jra78/sarastevalo/README.md

# sarastevalo
"Sarastevalo eagle" hekemistosta löytyy piirilevyä varten eagle tiedostot (useampia versioita)
"Sarastevalo arduino" hakemistosta löytyy koodi

in "Sarastevalo eagle"-folder is eagle files (multiple versions)
in "Sarastevalo arduino" folder is code
