jra78/sarastevalo/sarastevalo eagle/controller.brd

## EAGLE design sarastevalo eagle/controller.brd (2015-01-12)

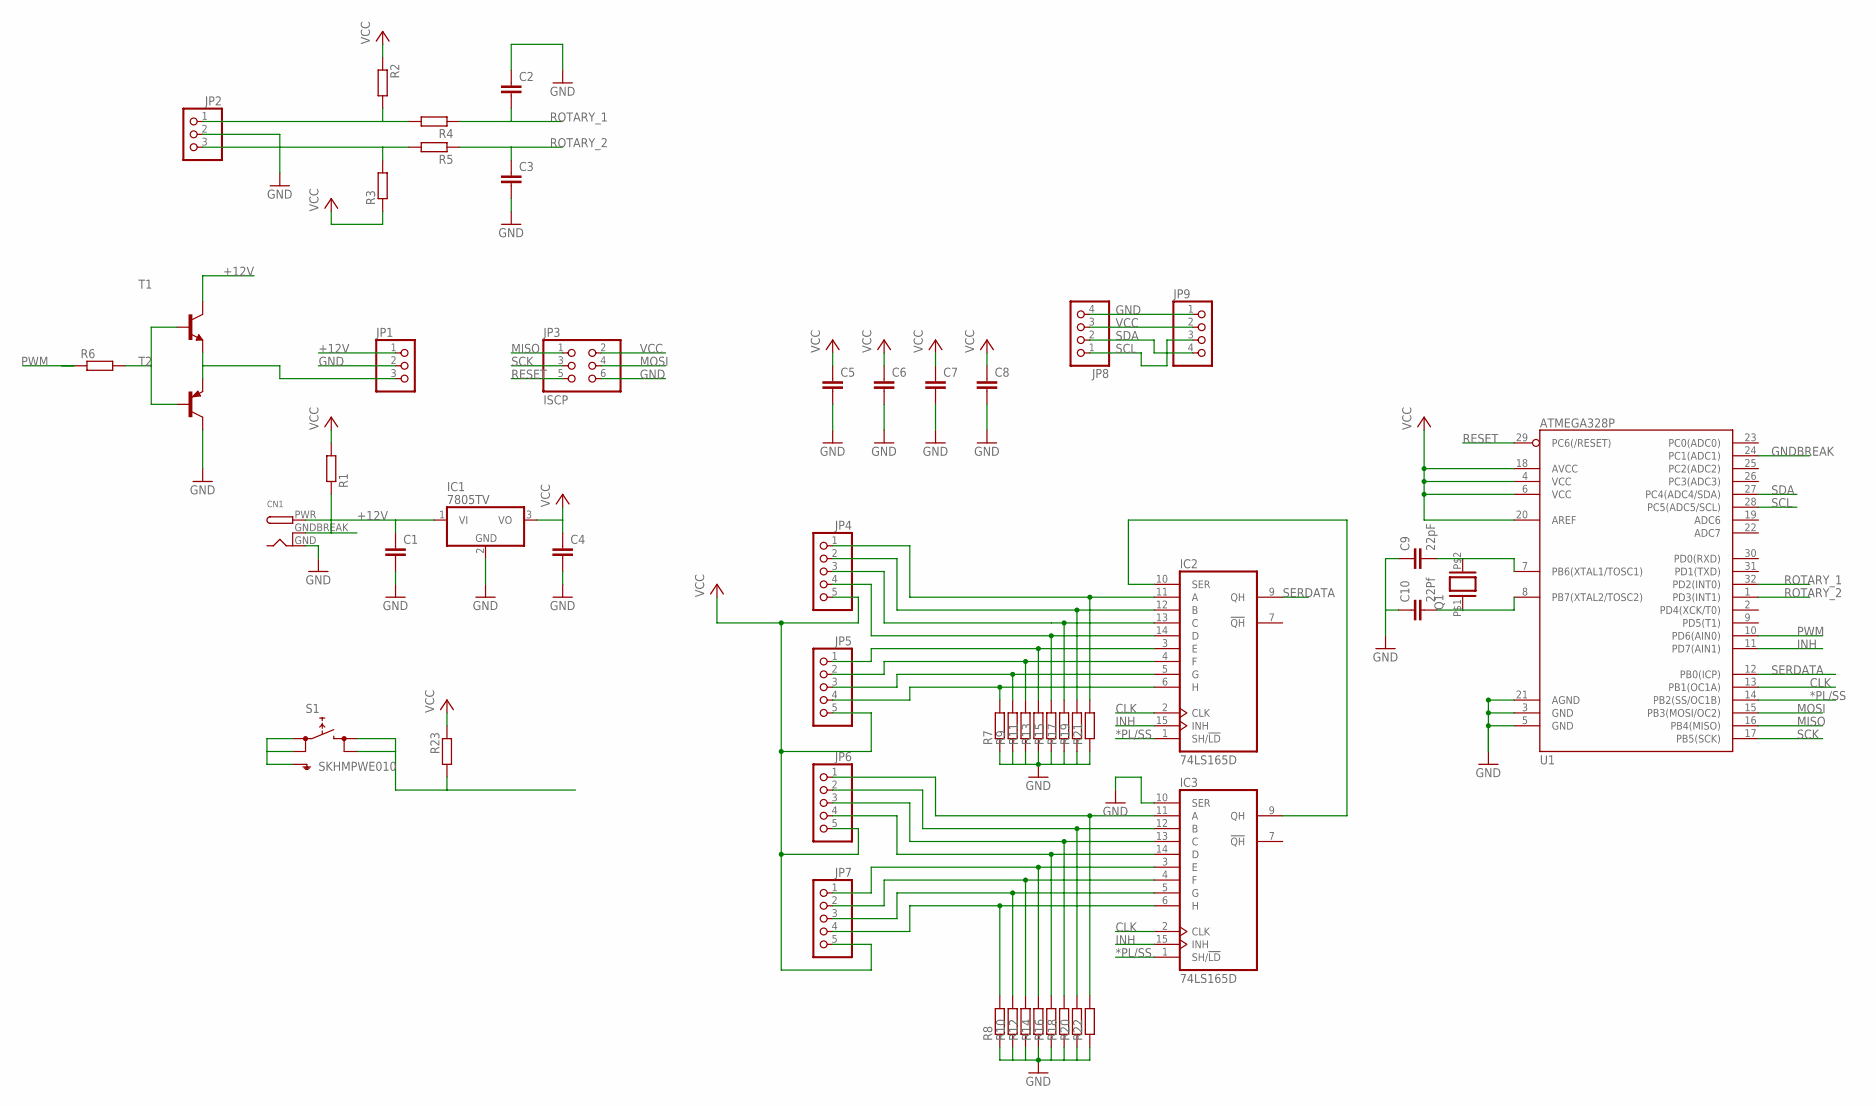
[picture p1: schematic controller.sch]

Parts:
C1, C2, C3, C4, C5, C6, C7, C8: C-EUC0805; C0805
C9: 22pF; C0805
C10: 22Pf; C0805
CN1: DCBARRELPTH; DCJACK_2MM_PTH
IC1: 7805TV; TO220V
IC2, IC3: 74LS165D; SO16
JP1, JP2: PINHD-1X3; 1X03
JP3: ISCP; 2X03
JP4, JP5, JP6, JP7: PINHD-1X5; 1X05
JP8, JP9: PINHD-1X4; 1X04
Q1: XTAL; CSM-3X
R1, R2, R3, R4, R5, R6, R7, R8, R9, R10, R11, R12, R13, R14, R15, R16, R17, R18, R19, R20, R21, R22, R23: R-EU_R0805; R0805
S1: SKHMPWE010; SKHMPXE010
T1: BC847-NPN-SOT23-BEC; SOT23-BEC
T2: BC807-16-PNP-SOT23-BEC; SOT23-BEC
U1: ATMEGA328P; TQFP32-08

Connections:
*PL/SS: IC2.1 (SH/!LD), IC3.1 (SH/!LD), U1.14 (PB2(SS/OC1B))
+12V: C1.1, CN1.PWR, IC1.1 (VI), JP1.1, T1.C
CLK: IC2.2 (CLK), IC3.2 (CLK), U1.13 (PB1(OC1A))
GND: C1.2, C2.1, C3.2, C4.2, C5.2, C6.2, C7.2, C8.2, C9.1, C10.1, CN1.GND, IC1.2 (GND), IC2.8 (GND), IC3.8 (GND), IC3.10 (SER), JP1.2, JP2.2, JP3.6, JP8.4, JP9.1, R7.1, R8.1, R9.1, R10.1, R11.1, R12.1, R13.1, R14.1, R15.1, R16.1, R17.1, R18.1, R19.1, R20.1, R21.1, R22.1, S1.1 (1.1), S1.2 (1.2), S1.5 (SH), T2.C, U1.3 (GND), U1.5 (GND), U1.21 (AGND)
GNDBREAK: CN1.GNDBREAK, R1.1, U1.24 (PC1(ADC1))
INH: IC2.15 (INH), IC3.15 (INH), U1.11 (PD7(AIN1))
MISO: JP3.1, U1.16 (PB4(MISO))
MOSI: JP3.4, U1.15 (PB3(MOSI/OC2))
unnamed: IC2.11 (A), JP4.1, R21.2
unnamed: IC2.12 (B), JP4.2, R19.2
unnamed: IC2.13 (C), JP4.3, R17.2
unnamed: IC2.14 (D), JP4.4, R15.2
unnamed: IC2.3 (E), JP5.1, R13.2
unnamed: IC2.4 (F), JP5.2, R11.2
unnamed: IC2.5 (G), JP5.3, R9.2
unnamed: IC2.6 (H), JP5.4, R7.2
unnamed: IC3.11 (A), JP6.1, R22.2
unnamed: IC3.12 (B), JP6.2, R20.2
unnamed: IC3.13 (C), JP6.3, R18.2
unnamed: IC3.14 (D), JP6.4, R16.2
unnamed: IC3.3 (E), JP7.1, R14.2
unnamed: IC3.4 (F), JP7.2, R12.2
unnamed: IC3.5 (G), JP7.3, R10.2
unnamed: IC3.6 (H), JP7.4, R8.2
unnamed: JP2.1, R2.2, R4.2
unnamed: JP1.3, T1.E, T2.E
unnamed: JP2.3, R3.2, R5.2
unnamed: IC2.10 (SER), IC3.9 (QH)
unnamed: C9.2, Q1.P$2 (2), U1.7 (PB6(XTAL1/TOSC1))
unnamed: C10.2, Q1.P$1 (1), U1.8 (PB7(XTAL2/TOSC2))
unnamed: R6.2, T1.B, T2.B
PWM: R6.1, U1.10 (PD6(AIN0))
RESET: JP3.5, R23.2, S1.3 (2.1), S1.4 (2.2), U1.29 (PC6(/RESET))
ROTARY_1: C2.2, R4.1, U1.32 (PD2(INT0))
ROTARY_2: C3.1, R5.1, U1.1 (PD3(INT1))
SCK: JP3.3, U1.17 (PB5(SCK))
SCL: JP8.1, JP9.3, U1.28 (PC5(ADC5/SCL))
SDA: JP8.2, JP9.4, U1.27 (PC4(ADC4/SDA))
SERDATA: IC2.9 (QH), U1.12 (PB0(ICP))
VCC: C4.1, C5.1, C6.1, C7.1, C8.1, IC1.3 (VO), IC2.16 (VCC), IC3.16 (VCC), JP3.2, JP4.5, JP5.5, JP6.5, JP7.5, JP8.3, JP9.2, R1.2, R2.1, R3.1, R23.1, U1.4 (VCC), U1.6 (VCC), U1.18 (AVCC), U1.20 (AREF)

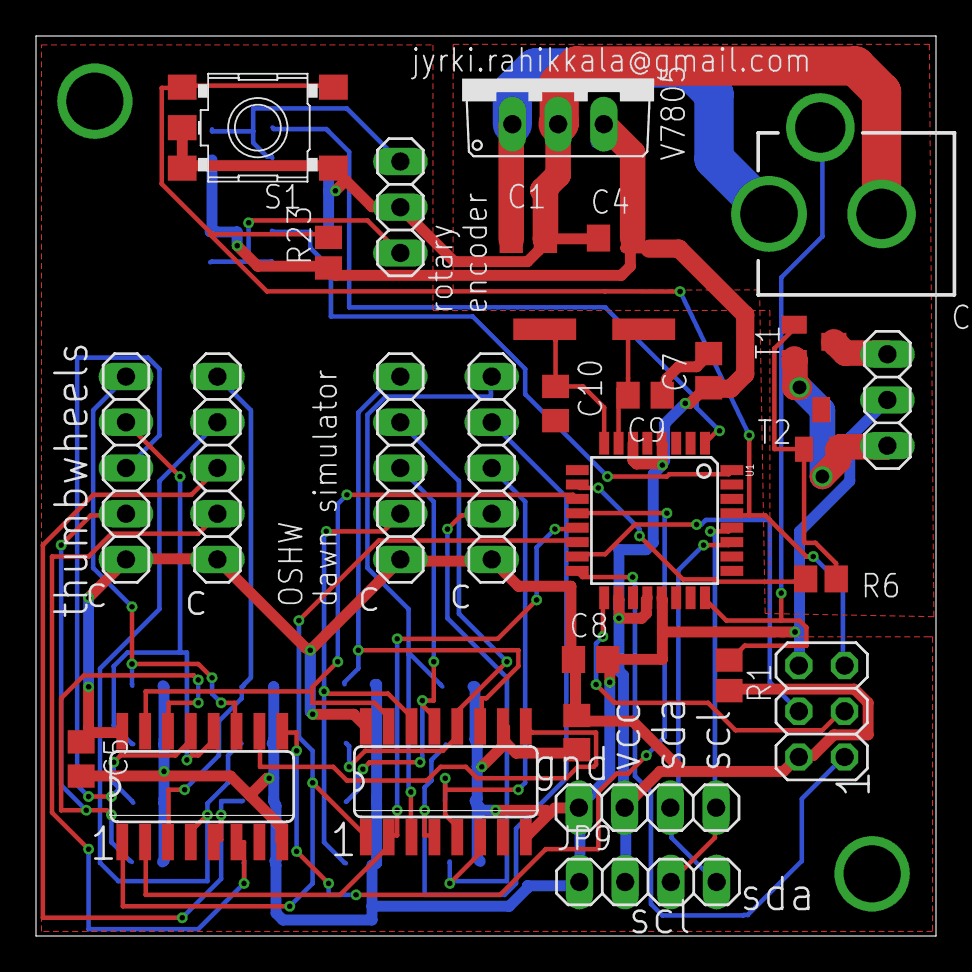
[picture p2: board controller.brd from above]

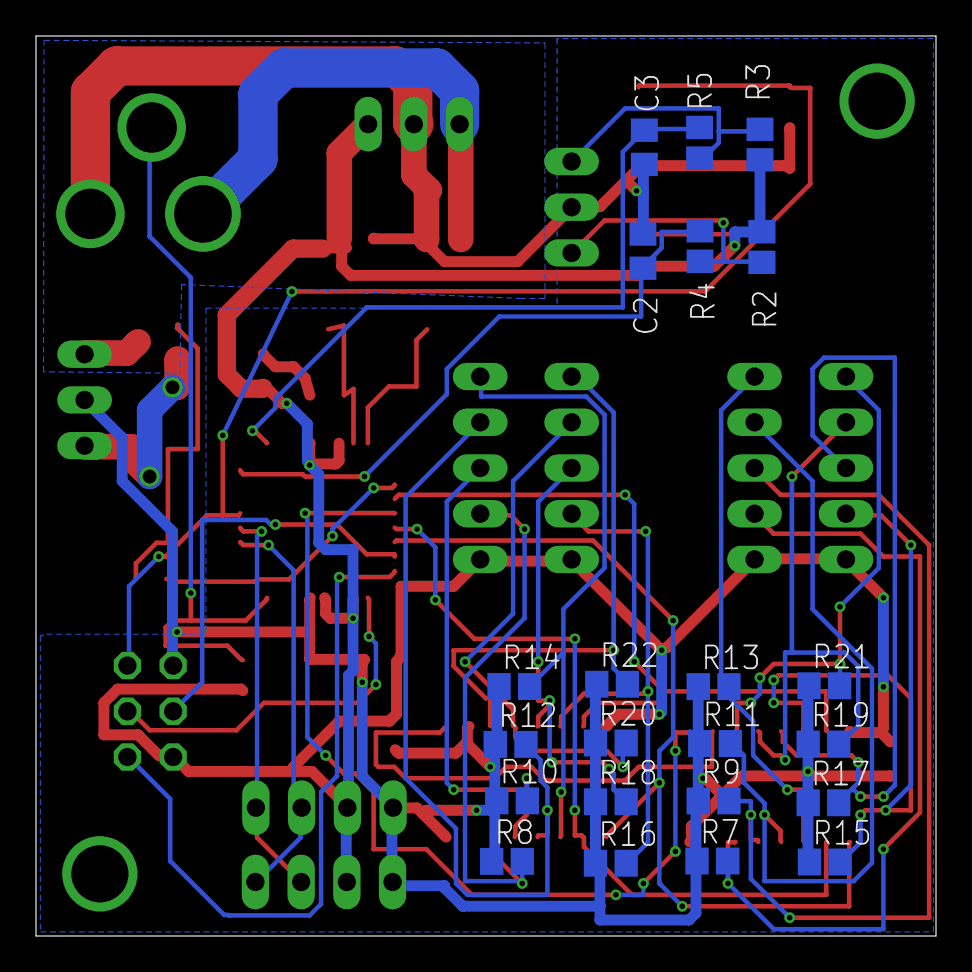
[picture p3: board controller.brd from below]

Board: 2 copper layers, 50.0 x 50.0 mm, 51 parts (22 on the bottom side), 40 nets.
