jra78/sarastevalo/(commit log)

2015-01-12 lisätty tiedostoja
    [_X4.brd, controller.brd, controller.sch, controllerver2.brd, controllerver2.sch, mosfet.brd, mosfet.sch, mosfet_ver2.brd]
2015-01-12 Changes to be committed: new file: sarastevalo arduino/sarastevalo.ino
2015-01-13 Encoder changes,pwm does not change from 0 to 255 or 255 to 0 so easy
